ryood/FV01/PXL_20220813_064847675.jpg

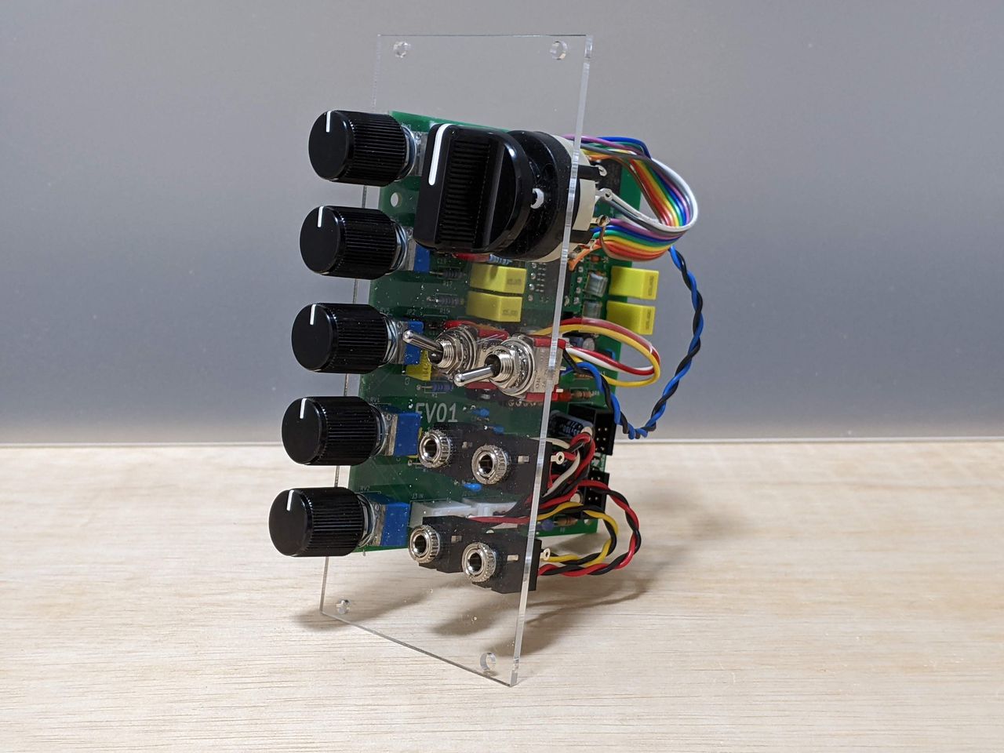
PXL_20220813_064847675.jpg
