ryood/FV01/PXL_20220806_094359794.jpg

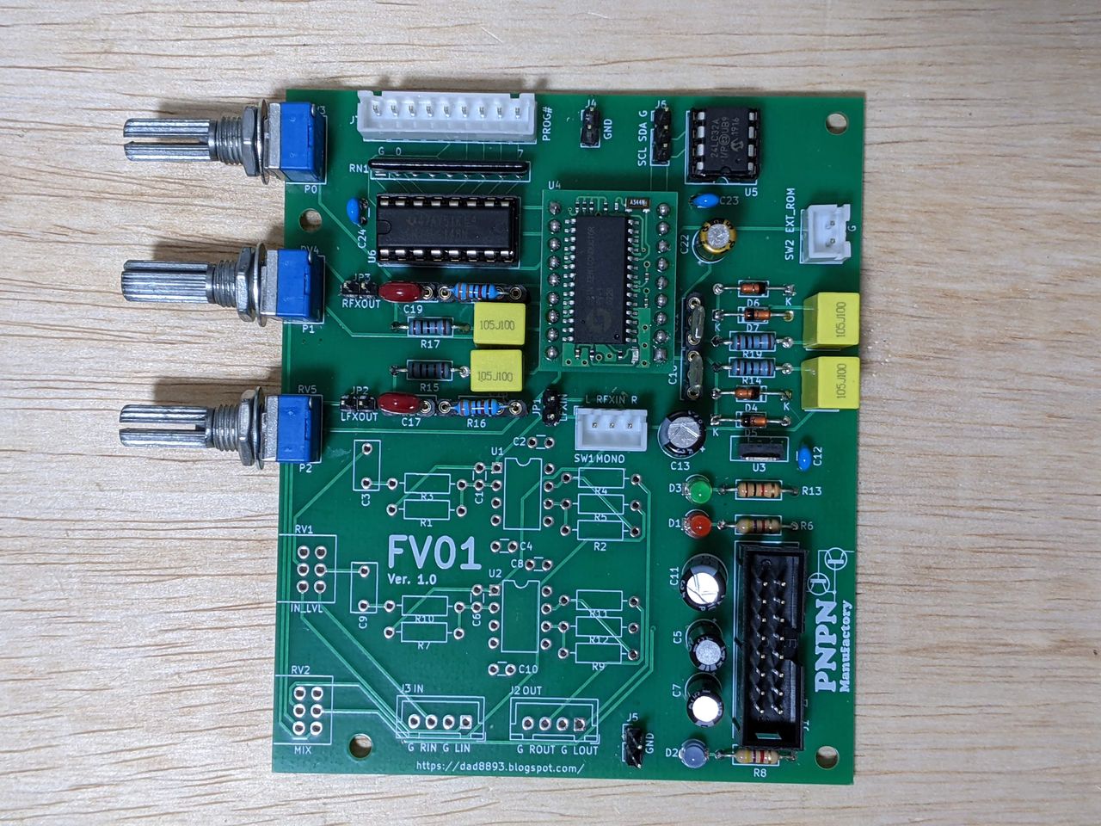
PXL_20220806_094359794.jpg
