ryood/FV01/FV01_Interface測定/FxOut-Out-INOUT_Lch.png

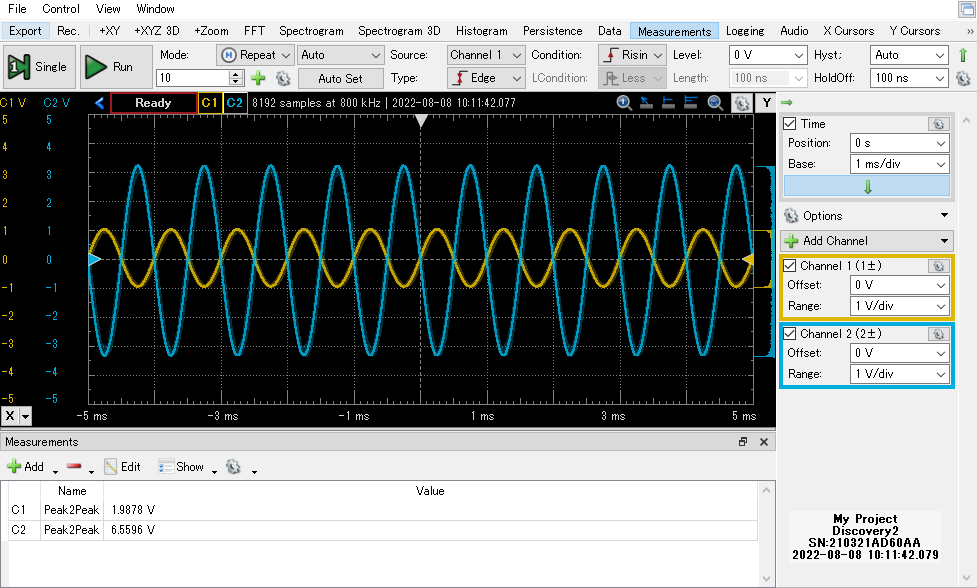
FV01_Interface測定/FxOut-Out-INOUT_Lch.png
