ryood/FV01/FV01_Interface測定/FxOut-Out-Network_Lch.png

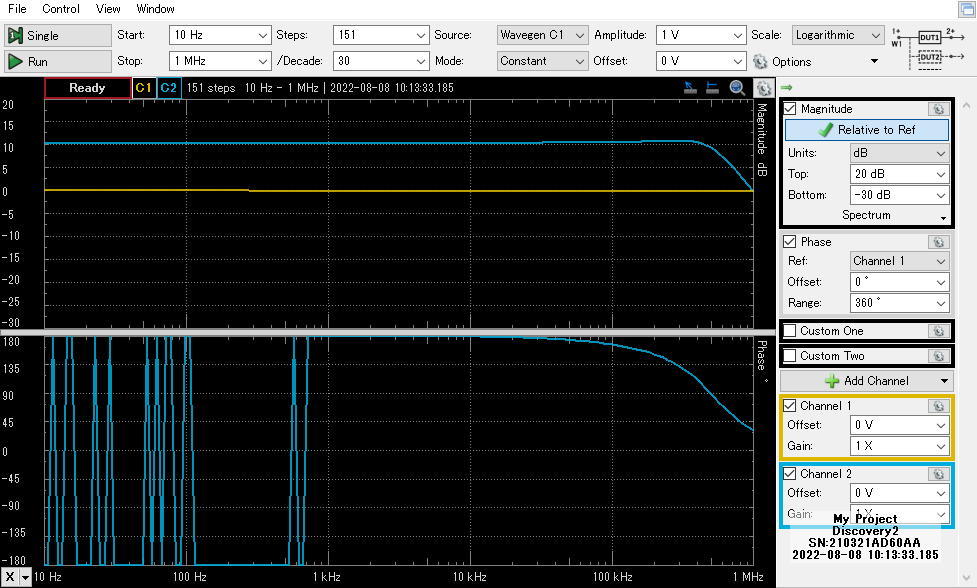
FV01_Interface測定/FxOut-Out-Network_Lch.png
