ryood/FV01/FV01_Interface測定/In-FxIn-INOUT_Lch.png

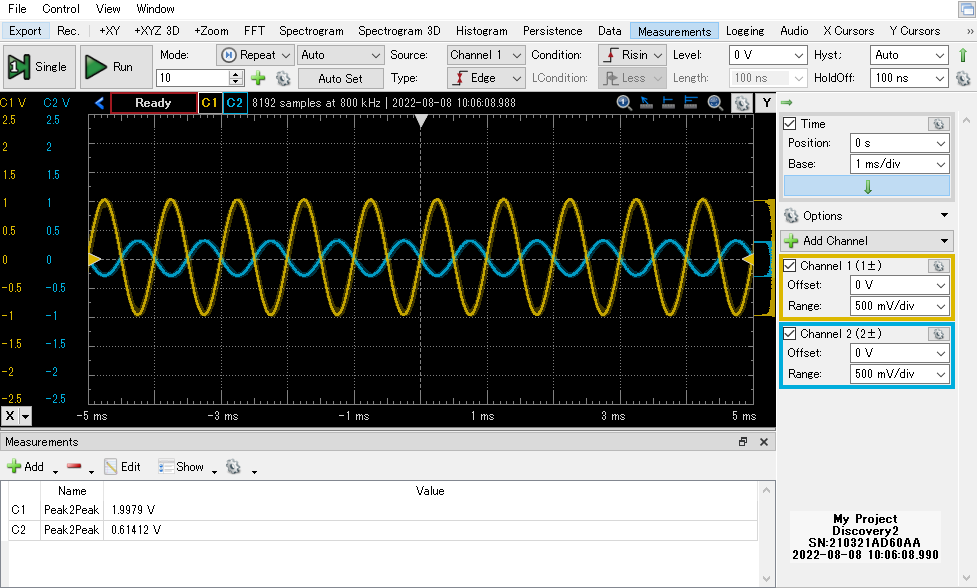
FV01_Interface測定/In-FxIn-INOUT_Lch.png
