ryood/FV01/FV01_Interface測定/IN-FxOut-Mix-Inv-LMax_Lch.PNG

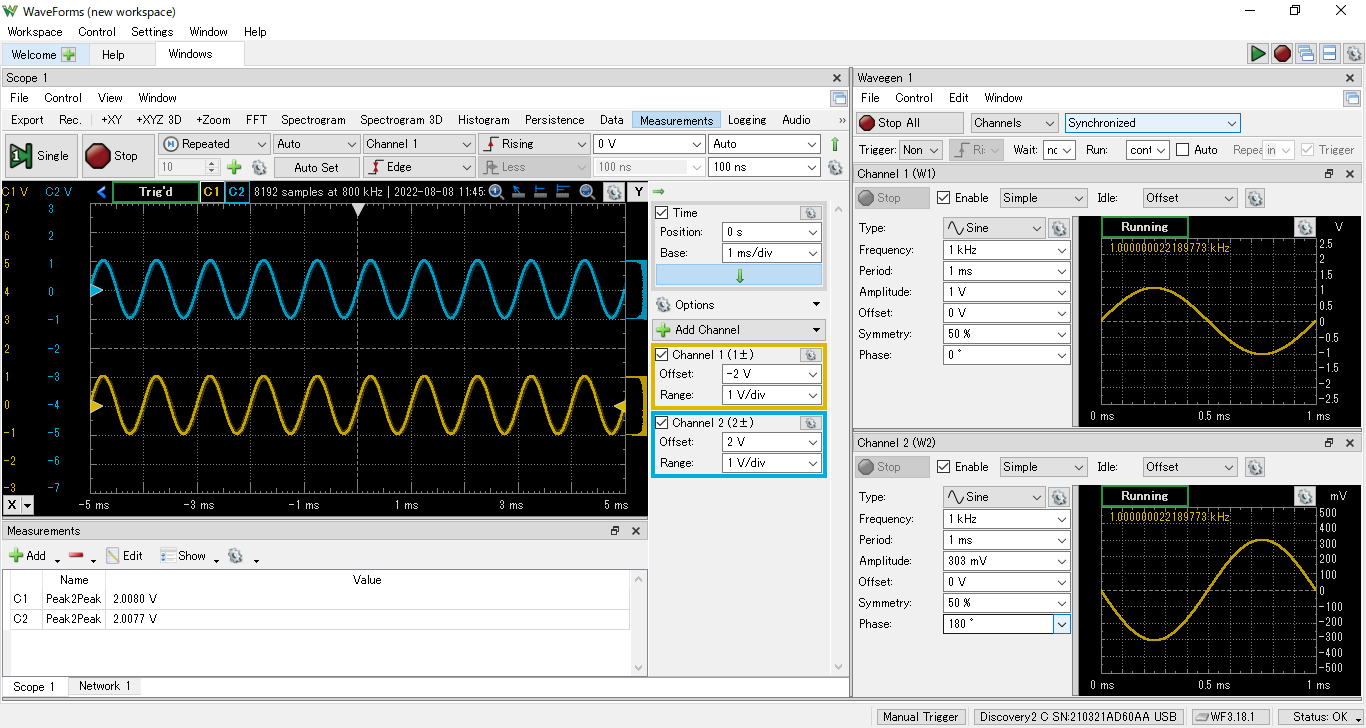
FV01_Interface測定/IN-FxOut-Mix-Inv-LMax_Lch.PNG
