ryood/FV01/FV01_Interface測定/In-Out-INOUT-LMax_Lch.png

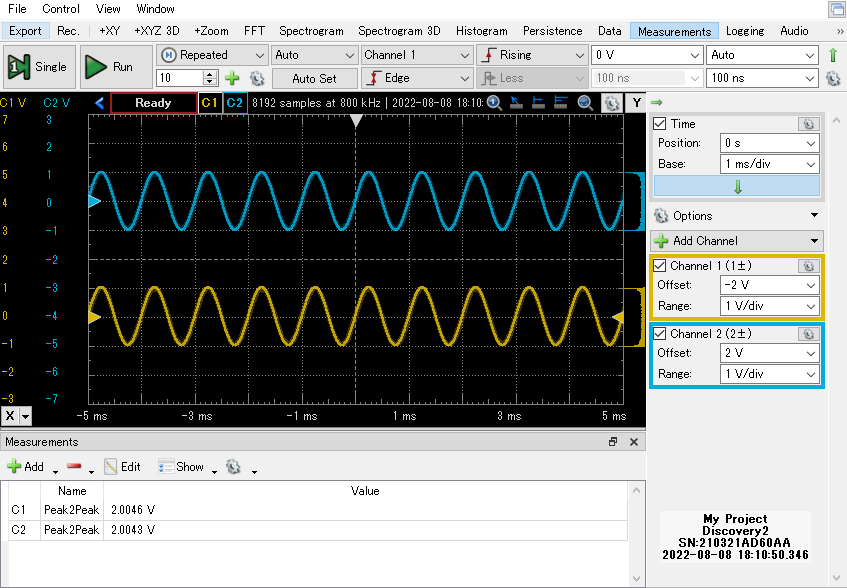
FV01_Interface測定/In-Out-INOUT-LMax_Lch.png
