ryood/FV01/FV01_Interface測定/In-Out-INOUT-RMax_Lch.png

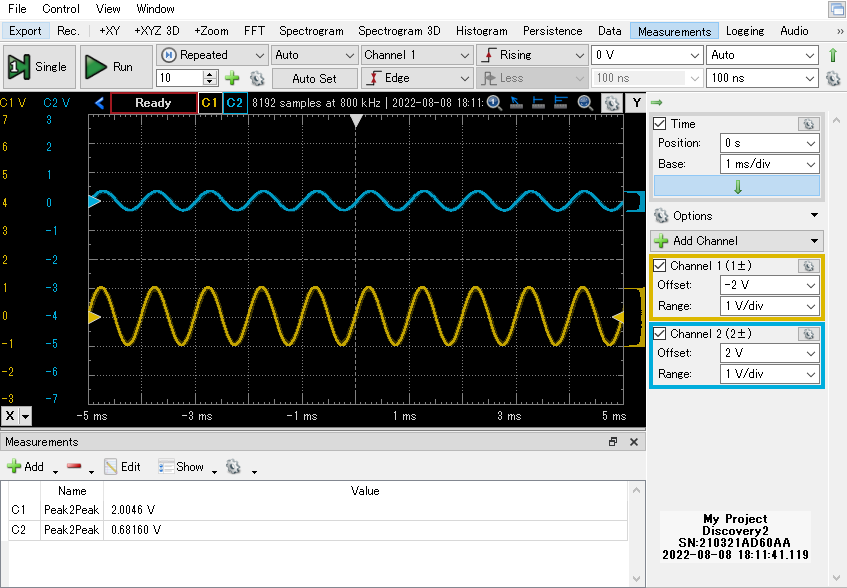
FV01_Interface測定/In-Out-INOUT-RMax_Lch.png
