ryood/FV01/FV01_Interface測定/In-Out-Network-LMax_Lch.png

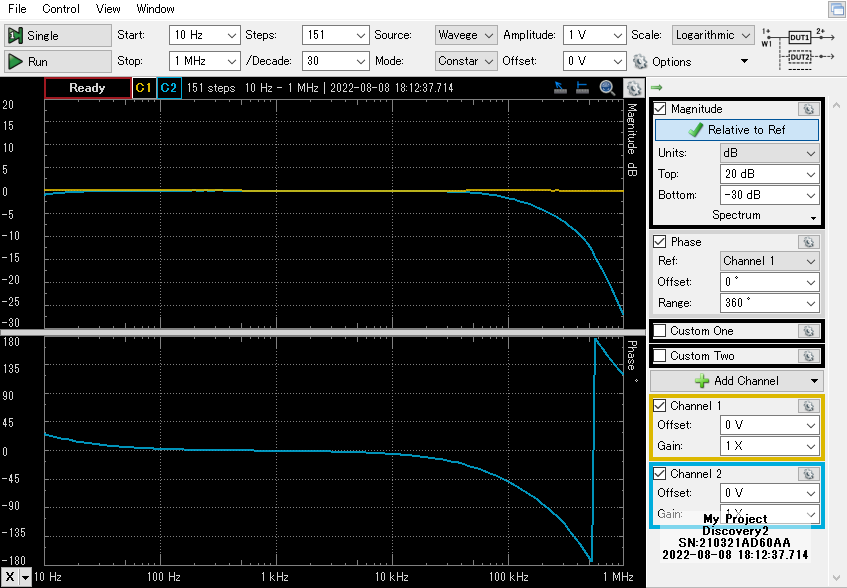
FV01_Interface測定/In-Out-Network-LMax_Lch.png
