ryood/FV01/KiCAD5/FV01.png

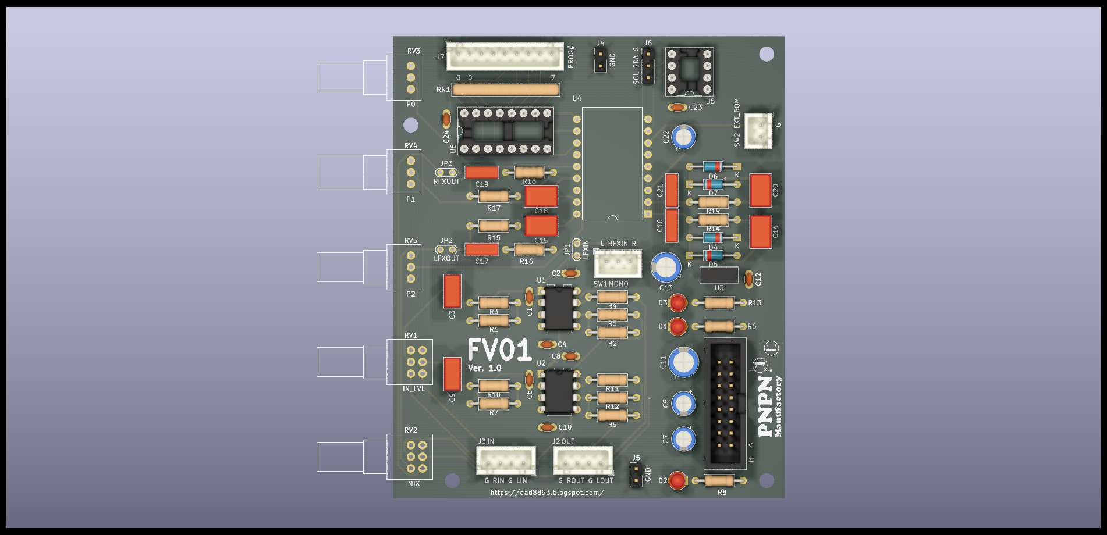
KiCAD5/FV01.png
