ryood/FV01/KiCAD5/FV01_Core_sch.png

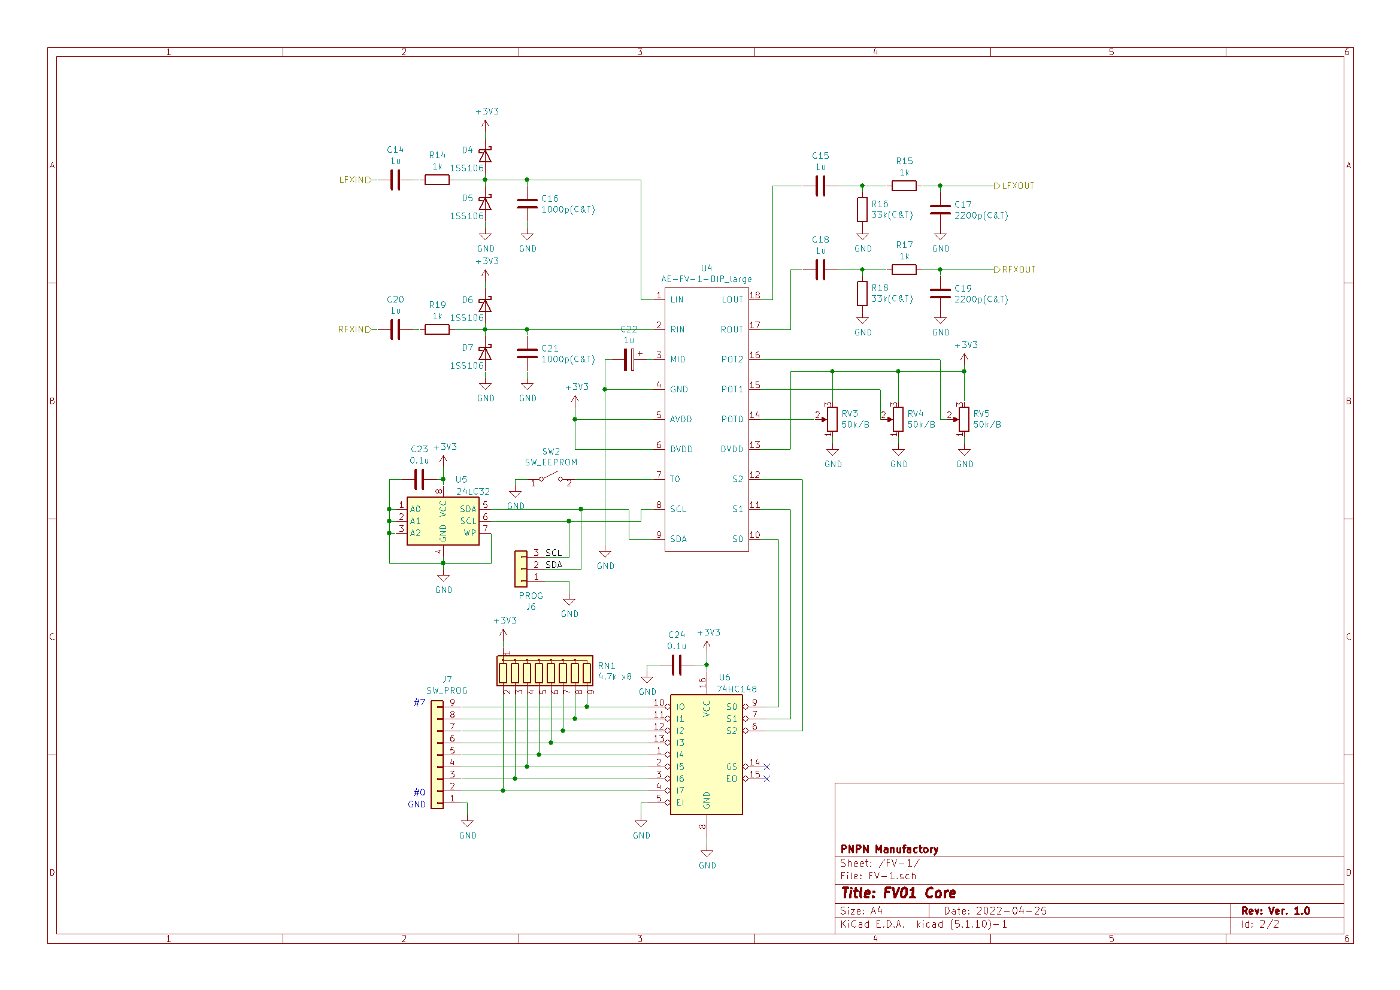
KiCAD5/FV01_Core_sch.png
