ryood/FV01/KiCAD5/FV01_sch.png

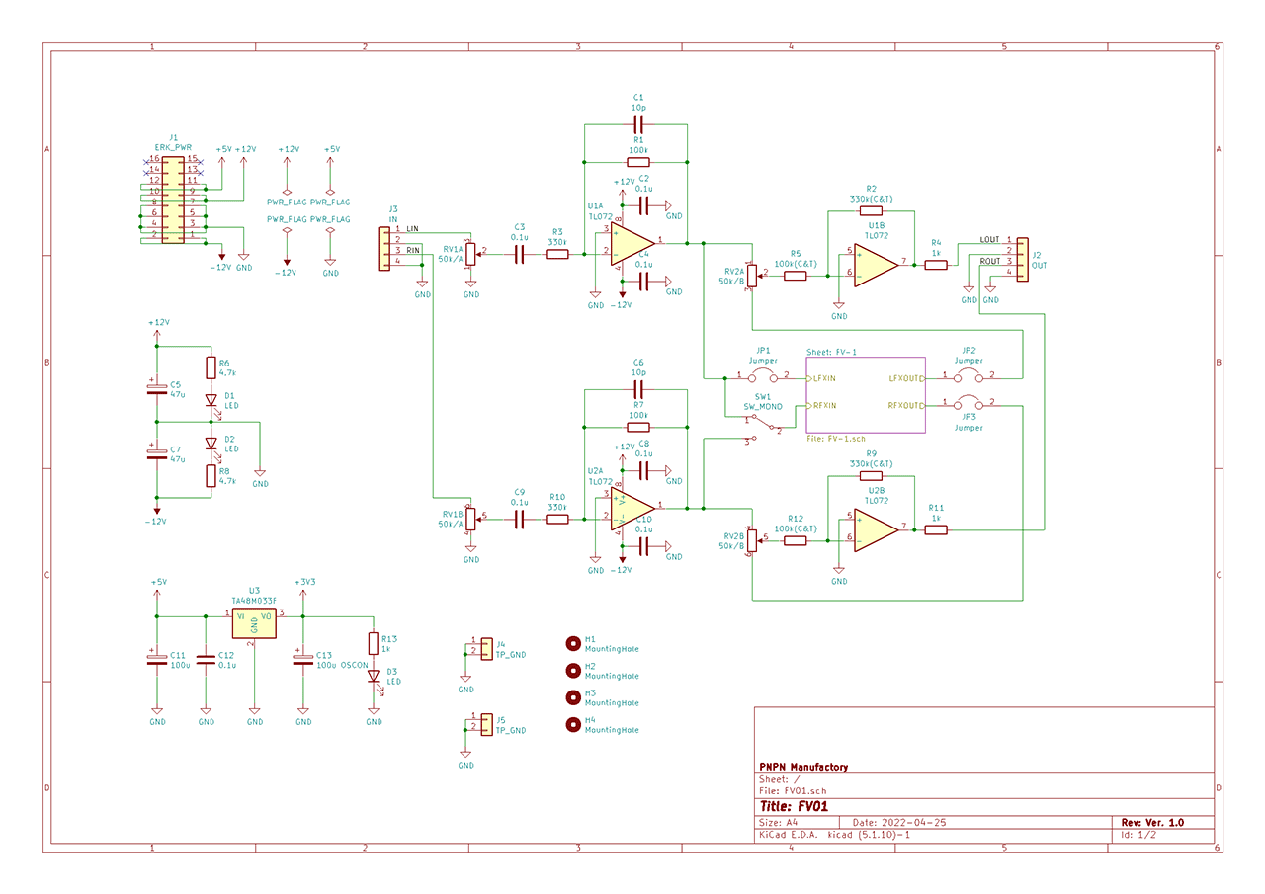
KiCAD5/FV01_sch.png
