ryood/FV01/spice/DRY_WET_1_Buffered_tran.png

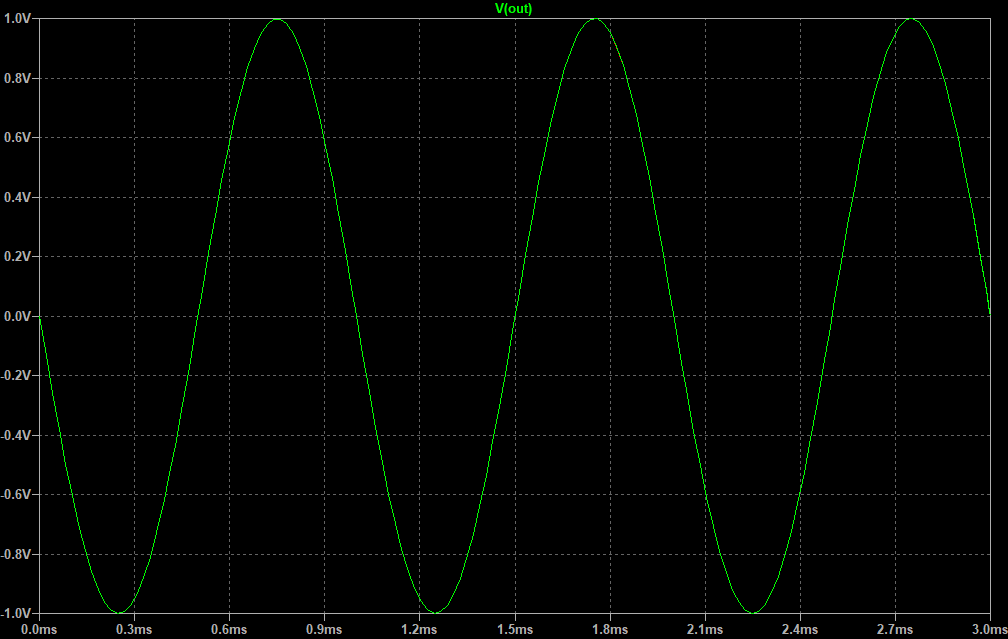
spice/DRY_WET_1_Buffered_tran.png
