ryood/FV01/spice/DRY_WET_1_NonInv_sch.png

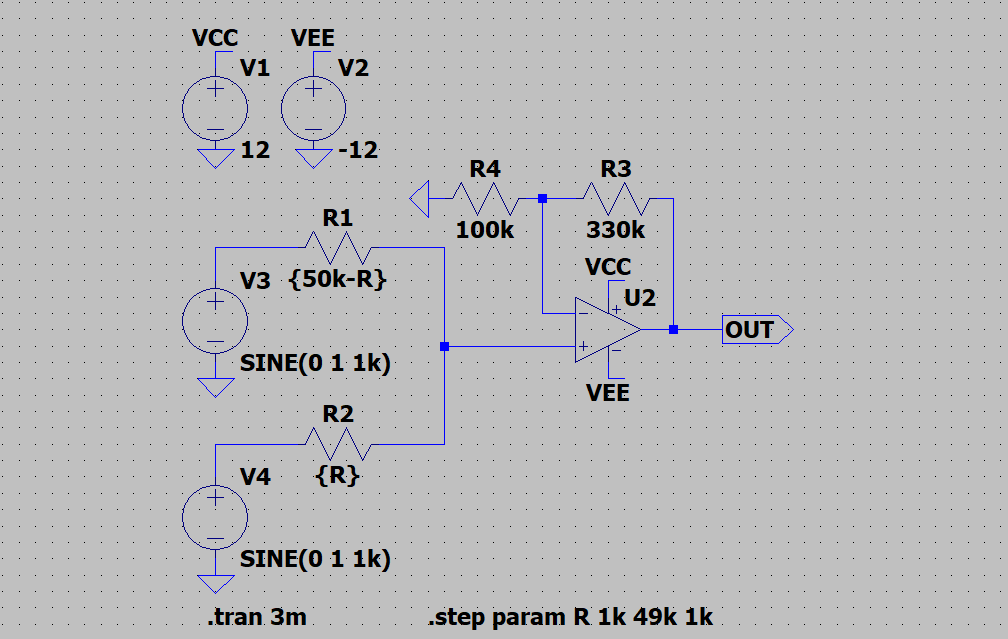
spice/DRY_WET_1_NonInv_sch.png
