ryood/FV01/spice/DRY_WET_1_NonInv_tran.png

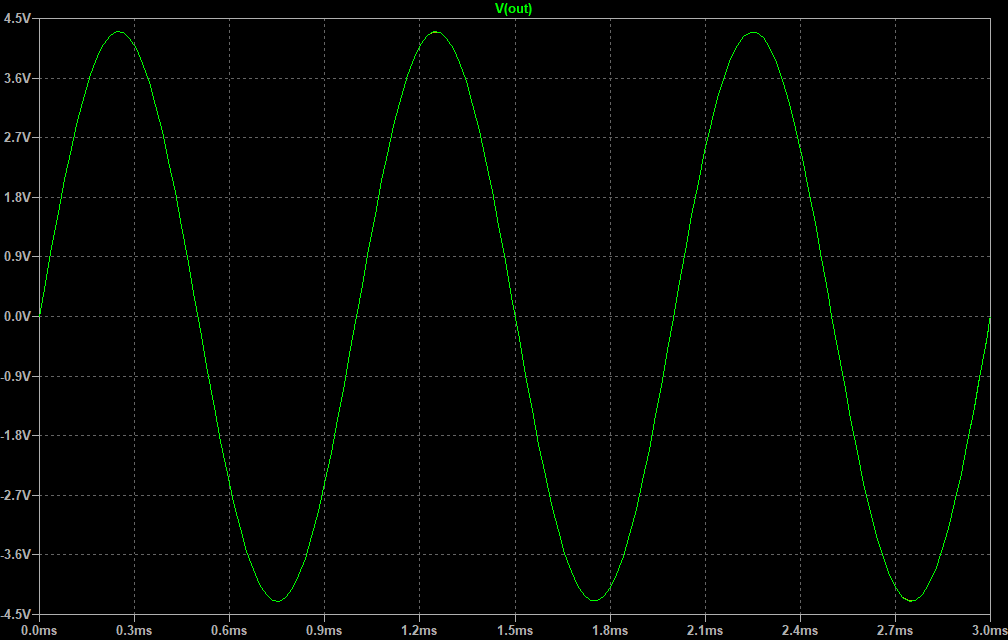
spice/DRY_WET_1_NonInv_tran.png
