ryood/FV01/spice/DRY_WET_1_sch.png

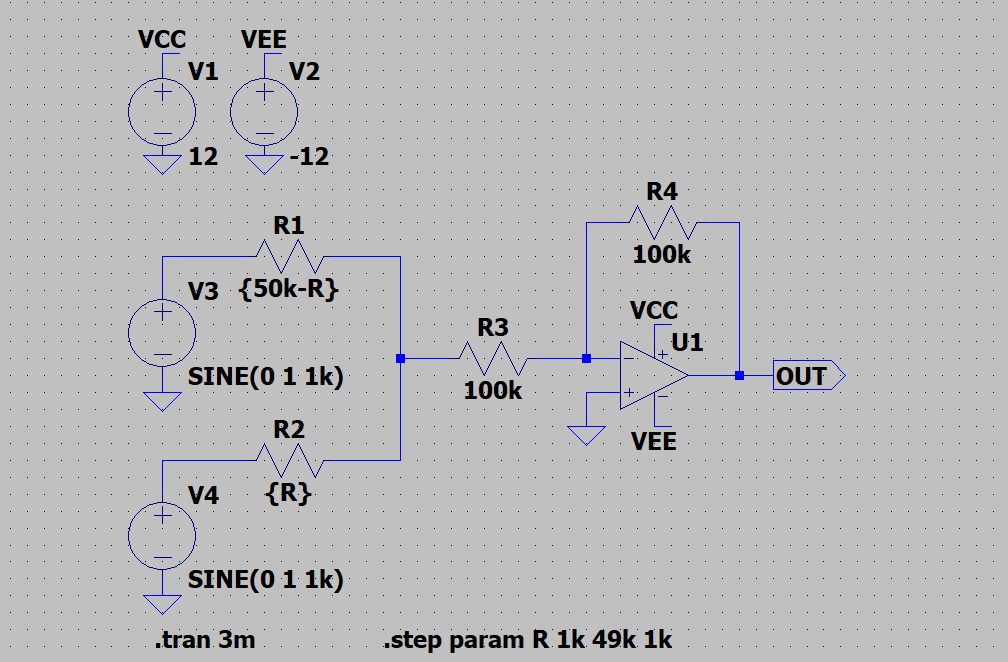
spice/DRY_WET_1_sch.png
