ryood/FV01/spice/DRY_WET_2_sch.png

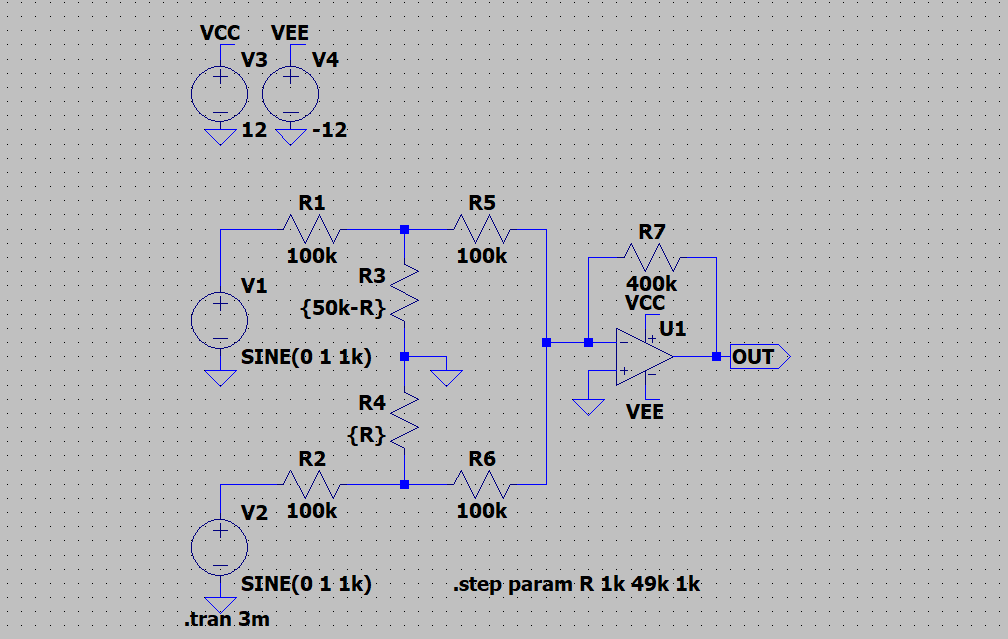
spice/DRY_WET_2_sch.png
