ryood/FV01/spice/DRY_WET_2_tran.png

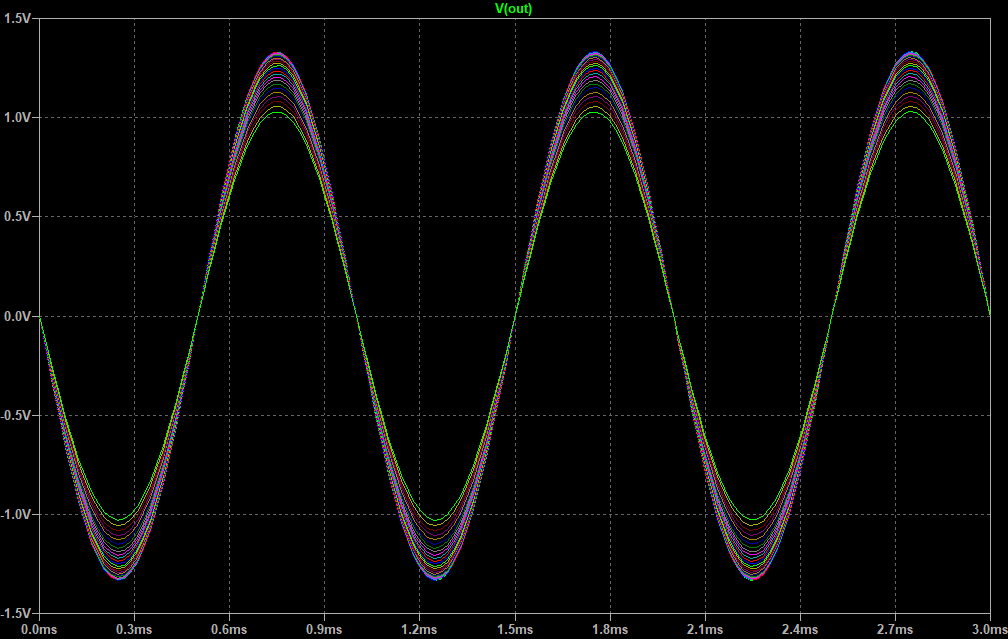
spice/DRY_WET_2_tran.png
