ryood/FV01/spice/DRY_WET_FV-1_Buffered_tran_zoom.png

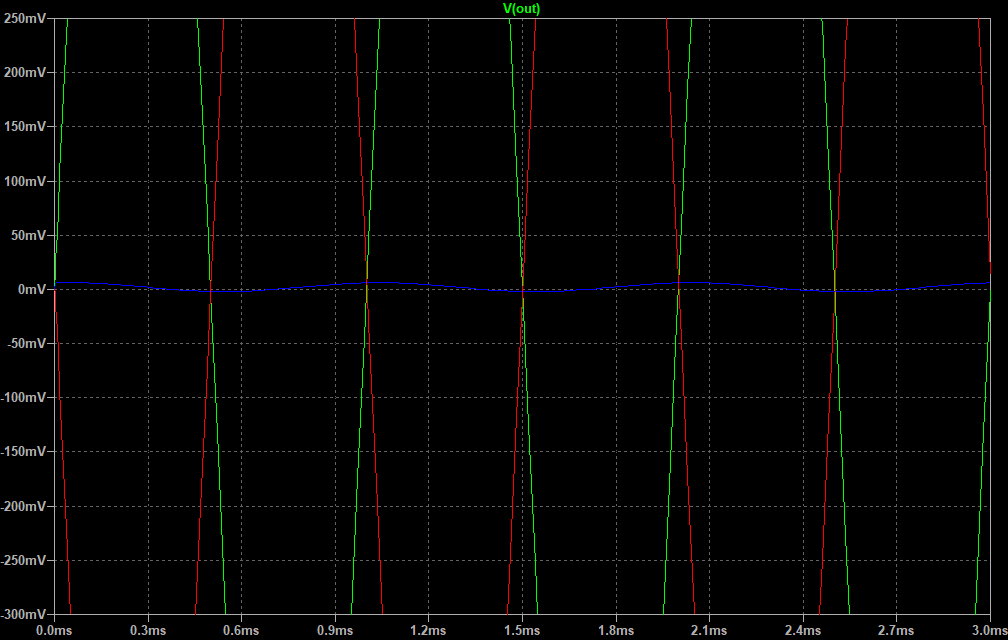
spice/DRY_WET_FV-1_Buffered_tran_zoom.png
