ryood/FV01/spice/DRY_WET_FV-1_sch.png

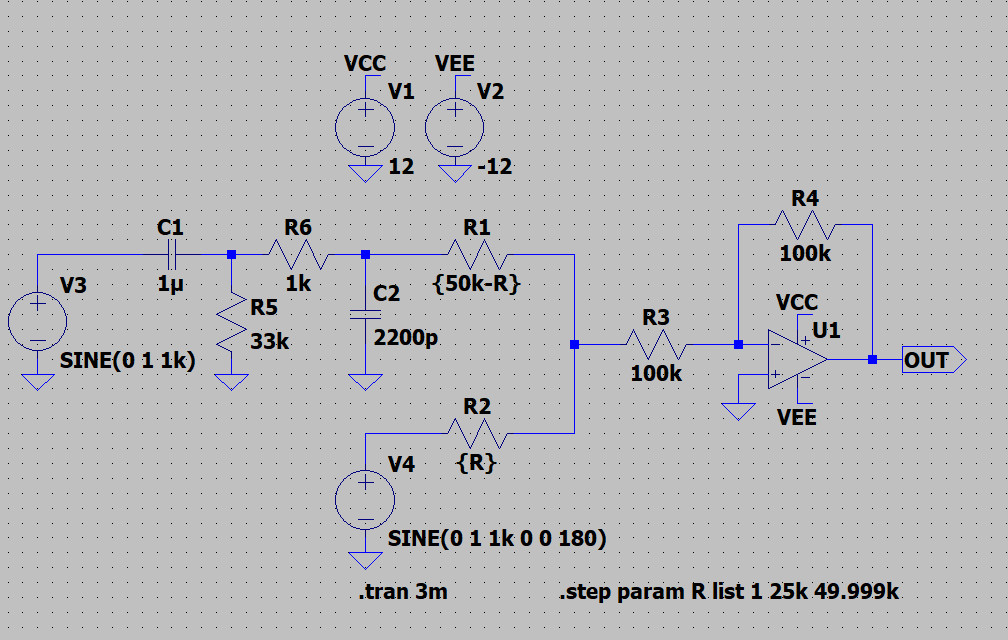
spice/DRY_WET_FV-1_sch.png
