ryood/FV01/spice/DRY_WET_FV-1_tran.png

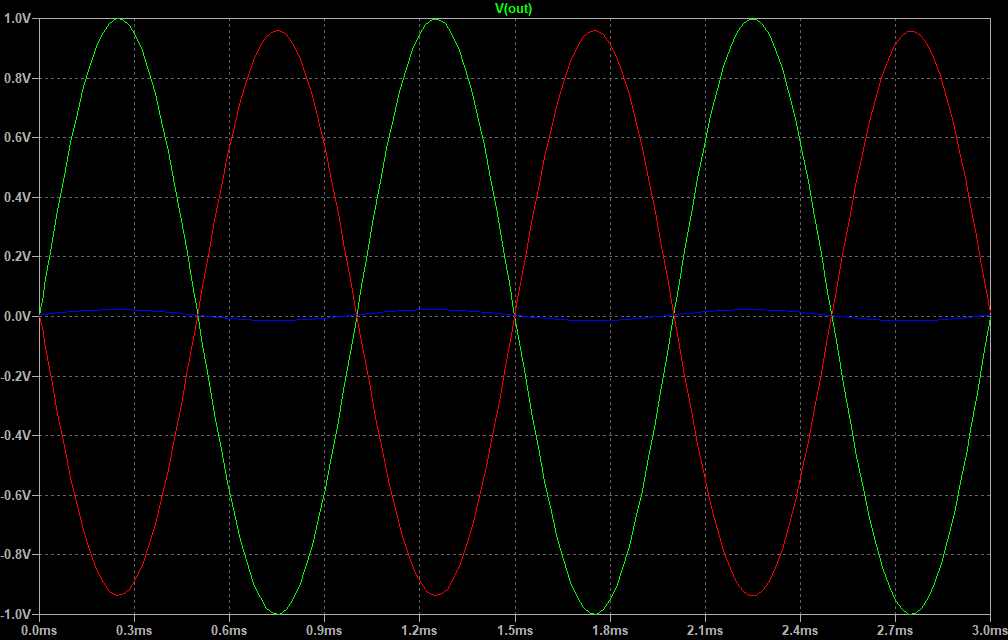
spice/DRY_WET_FV-1_tran.png
