ryood/FV01/spice/Nofilter_sch.png

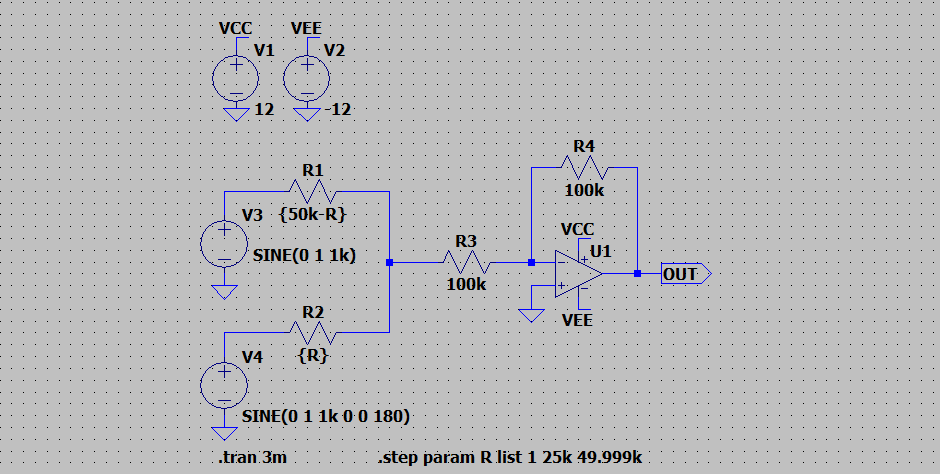
spice/Nofilter_sch.png
