ryood/FV01/spice/Nofilter_tran.png

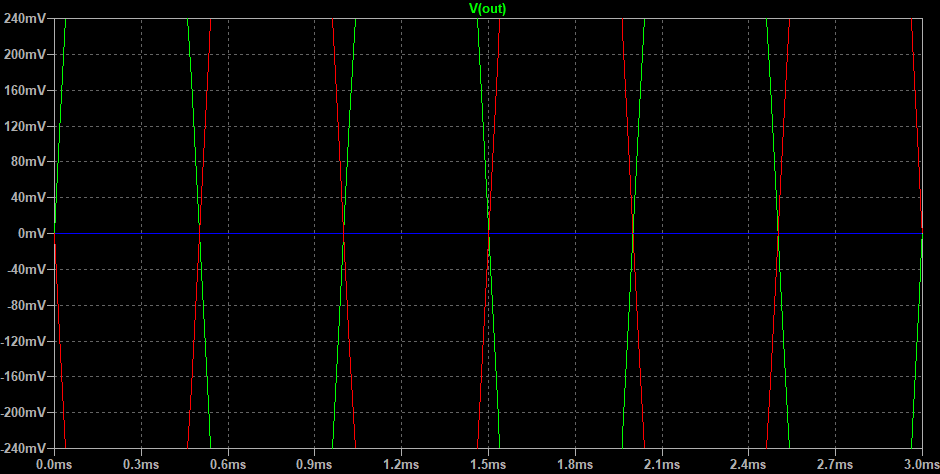
spice/Nofilter_tran.png
