ryood/FV01/SpnRomWriter/KiCAD6/PicoRomWriter_sch.png

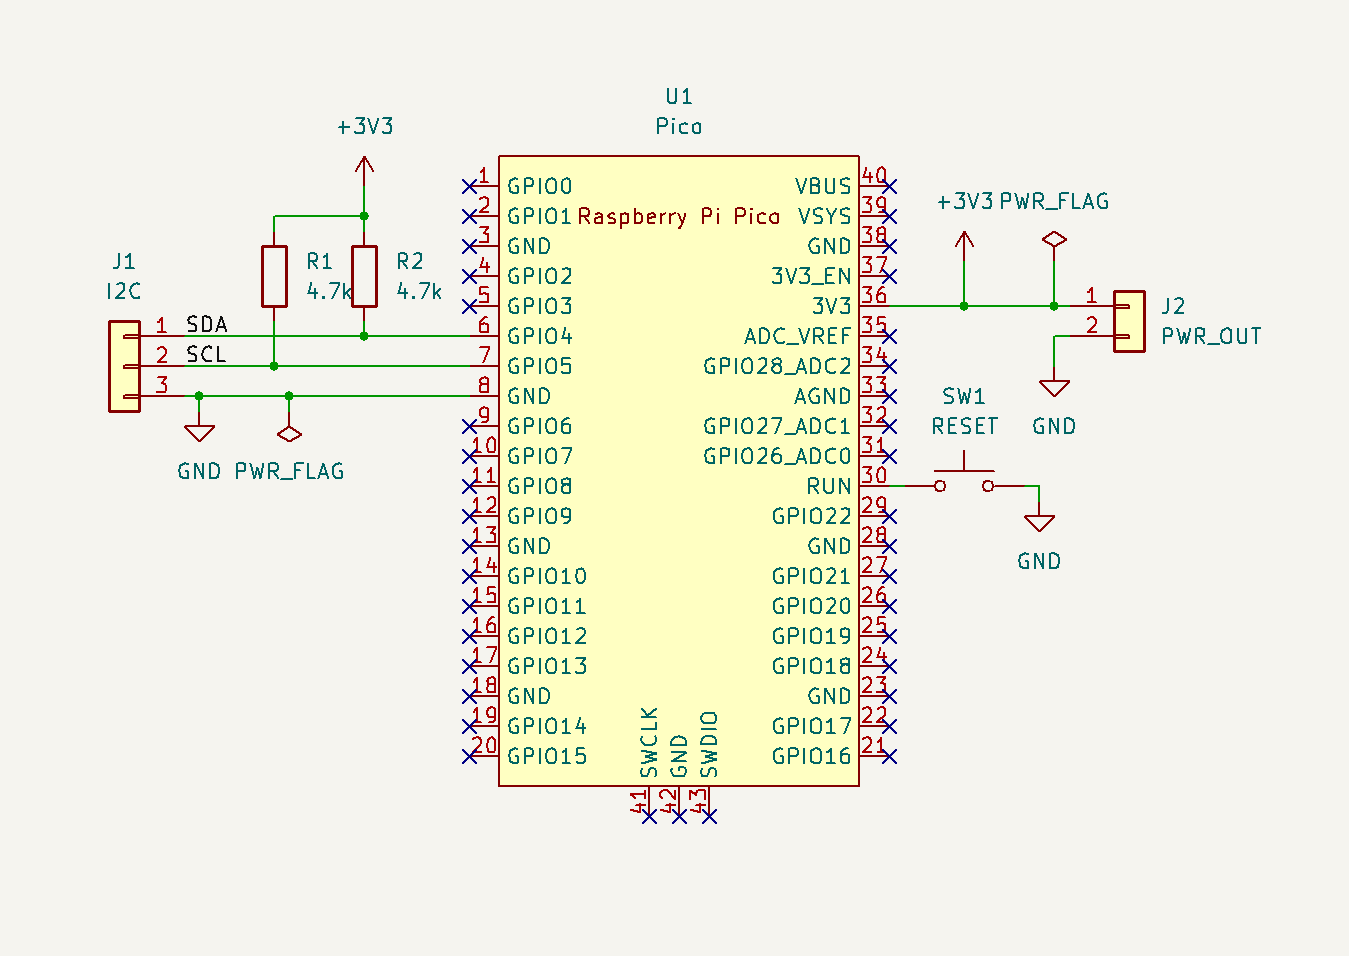
SpnRomWriter/KiCAD6/PicoRomWriter_sch.png
