ryood/FV01/(list of files, cad)

Other CAD files:
CAD/FV01_Panel.dwg
