ryood/FV01/spice/Dry_Wet_Buffered_Test_01.asc

R1: res; {50k-R}
R2: res; {R}
R3: res; 100k
R4: res; 100k
U1: UniversalOpamp2
U2: UniversalOpamp2
V1: voltage; 12
V2: voltage; -12
V3: voltage; SINE(0 1 1k)
V4: voltage; SINE(0 1 1k)
Named nets: VCC, VEE, 0, OUT
.tran 3m
.step param R 1k 49k 1k
