ryood/FV01/spice/Dry_Wet_FV-1_Buffered_Test_01.asc

C1: cap; 1µ
C2: cap; 2200p
R1: res; {50k-R}
R2: res; {R}
R3: res; 100k
R4: res; 100k
R5: res; 33k
R6: res; 1k
U1: UniversalOpamp2
U2: UniversalOpamp2
V1: voltage; 12
V2: voltage; -12
V3: voltage; SINE(0 1 1k)
V4: voltage; SINE(0 1 1k 0 0 180)
Named nets: VCC, VEE, 0, OUT
.tran 3m
.step param R list 1 25k 49.999k
