ryood/FV01/spice/Dry_Wet_Pan_Test_01.asc

R1: res; 100k
R2: res; 100k
R3: res; {50k-R}
R4: res; {R}
R5: res; 100k
R6: res; 100k
R7: res; 400k
U1: UniversalOpamp2
V1: voltage; SINE(0 1 1k)
V2: voltage; SINE(0 1 1k)
V3: voltage; 12
V4: voltage; -12
Named nets: VCC, VEE, 0, OUT
.step param R 1k 49k 1k
.tran 3m
