ryood/FV01/spice/FV01_Output_Filter.asc

C1: cap; 1µ
C2: cap; 6800p
R1: res; 15k
R2: res; 1k
V1: voltage; ""; AC 1
Named nets: 0
.ac oct 20 10 100k
