ryood/FV01/KiCAD6/FV01 Ver.1.1/FV01.kicad_pcb

## KiCad design KiCAD6/FV01 Ver.1.1/FV01.kicad_pcb (2022-10-08)

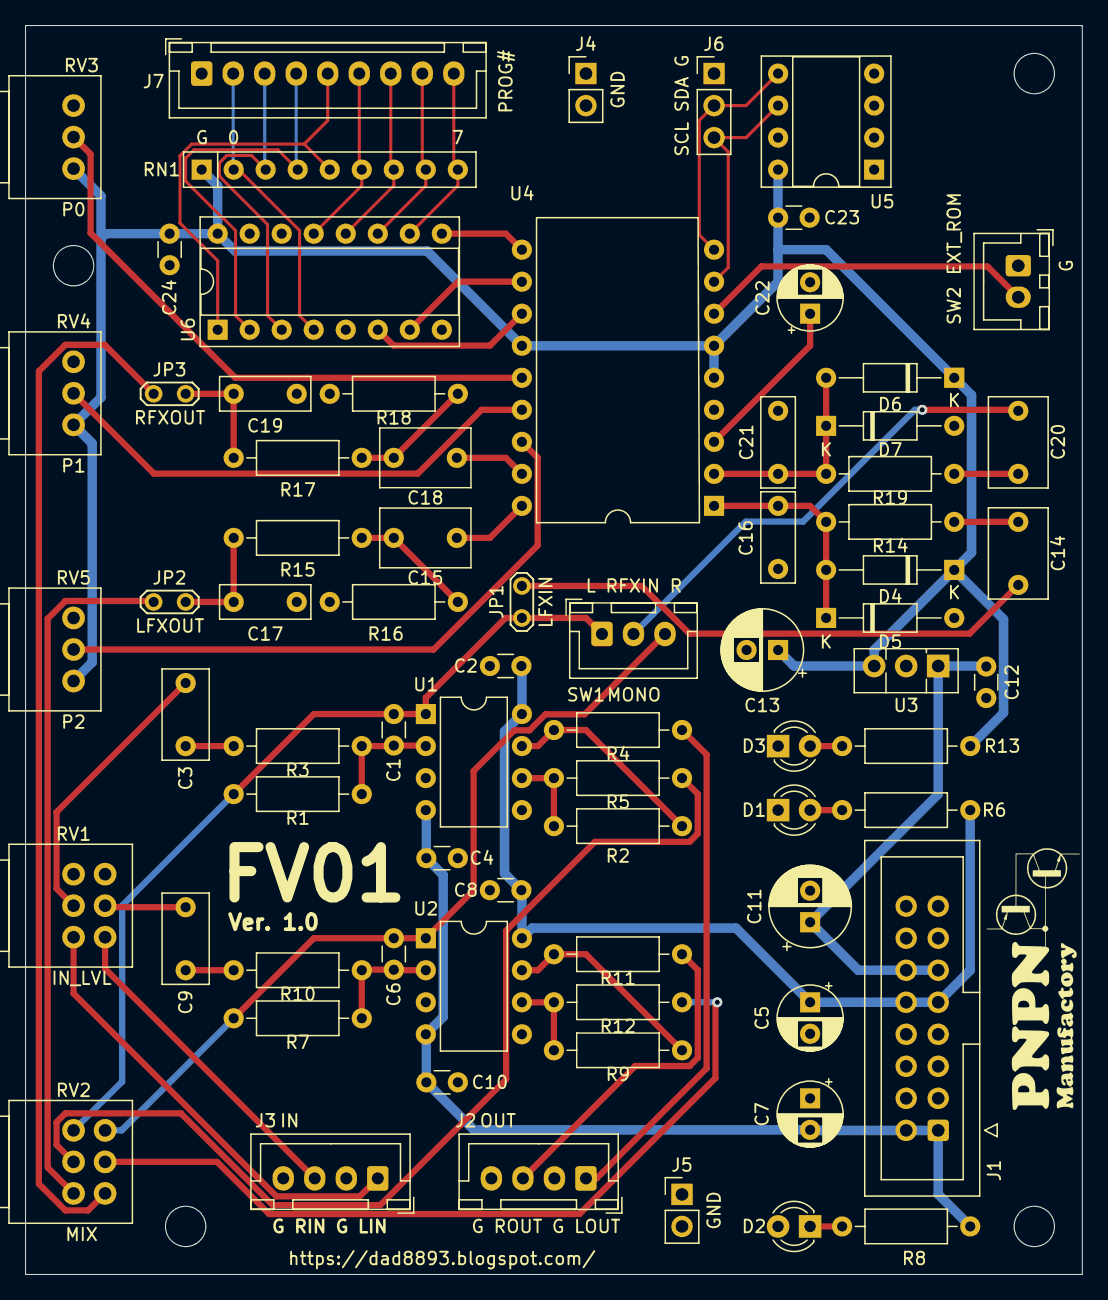
[picture p30: board FV01.kicad_pcb from above]

Board: 2 copper layers, 83.8 x 99.1 mm, 78 parts (0 on the bottom side), 58 nets.

Parts:
C1, C6: 10p; C_Disc_D3.0mm_W1.6mm_P2.50mm
C2, C4, C8, C10, C12, C23, C24: 0.1u; C_Disc_D3.0mm_W1.6mm_P2.50mm
C3, C9: 0.1u; C_Rect_L7.0mm_W3.5mm_P5.00mm
C5, C7: 47u; CP_Radial_D5.0mm_P2.50mm
C11, C13: 100u; CP_Radial_D6.3mm_P2.50mm
C14, C15, C18, C20: 1u; C_Rect_L7.0mm_W4.5mm_P5.00mm
C16, C21: 1000p(C&T); C_Rect_L7.0mm_W2.5mm_P5.00mm
C17, C19: 2200p(C&T); C_Rect_L7.0mm_W2.5mm_P5.00mm
C22: 1u; CP_Radial_D5.0mm_P2.50mm
D1, D2, D3: LED; LED_D3.0mm
D4, D5, D6, D7: 1SS106; D_DO-35_SOD27_P10.16mm_Horizontal
H1, H2, H3, H4: MountingHole; MountingHole_3.2mm_M3
J1: ERK_PWR; IDC-Header_2x08_P2.54mm_Vertical
J2: OUT; JST_XH_B4B-XH-A_1x04_P2.50mm_Vertical
J3: IN; JST_XH_B4B-XH-A_1x04_P2.50mm_Vertical
J4, J5: TP_GND; PinHeader_1x02_P2.54mm_Vertical
J6: PROG; PinHeader_1x03_P2.54mm_Vertical
J7: SW_PROG; JST_XH_B9B-XH-A_1x09_P2.50mm_Vertical
JP1, JP2, JP3: Jumper; TestPoint_2Pads_Pitch2.54mm_Drill0.8mm
R1, R7: 100k; R_Axial_DIN0207_L6.3mm_D2.5mm_P10.16mm_Horizontal
R2, R9: 330k(C&T); R_Axial_DIN0207_L6.3mm_D2.5mm_P10.16mm_Horizontal
R3, R10: 330k; R_Axial_DIN0207_L6.3mm_D2.5mm_P10.16mm_Horizontal
R4, R11, R13, R14, R15, R17, R19: 1k; R_Axial_DIN0207_L6.3mm_D2.5mm_P10.16mm_Horizontal
R5, R12: 100k(C&T); R_Axial_DIN0207_L6.3mm_D2.5mm_P10.16mm_Horizontal
R6, R8: 4.7k; R_Axial_DIN0207_L6.3mm_D2.5mm_P10.16mm_Horizontal
R16, R18: 33k(C&T); R_Axial_DIN0207_L6.3mm_D2.5mm_P10.16mm_Horizontal
RN1: 4.7k x8; R_Array_SIP9
RV1: 50k/A; Potentiometer_Alps_RK097_Dual_Horizontal
RV2: 50k/B; Potentiometer_Alps_RK097_Dual_Horizontal
RV3, RV4, RV5: 50k/B; Potentiometer_Alps_RK097_Single_Horizontal
SW1: SW_MONO; JST_XH_B3B-XH-A_1x03_P2.50mm_Vertical
SW2: SW_EEPROM; JST_XH_B2B-XH-A_1x02_P2.50mm_Vertical
U1, U2: TL072; DIP-8_W7.62mm
U3: TA48M033F; TO-126-3_Vertical
U4: AE-FV-1-DIP_large; DIP-18_W15.24mm
U5: 24LC32; DIP-8_W7.62mm_Socket
U6: 74HC148; DIP-16_W7.62mm_Socket

Connections:
+3V3: C13.1, C23.1, C24.1, D4.1, D6.1, R13.1, RN1.1, RV3.3, RV4.3, RV5.3, U3.3, U4.5, U4.6, U4.13, U5.8, U6.16
+5V: C11.1, C12.1, J1.11, J1.12, U3.1
+12V: C2.2, C5.1, C8.2, J1.9, J1.10, R6.1, U1.8, U2.8
-12V: C4.2, C7.2, C10.2, J1.1, J1.2, R8.2, U1.4, U2.4
/FV-1/LFXIN: C14.2, JP1.2
/FV-1/LFXOUT: C17.1, JP2.1, R15.1
/FV-1/RFXIN: C20.2, SW1.2
/FV-1/RFXOUT: C19.1, JP3.1, R17.1
/FV-1/SCL: J6.3, U4.8, U5.6
/FV-1/SDA: J6.2, U4.9, U5.5
/LIN: J3.1, RV1.3
/LOUT: J2.1, R4.1
/RIN: J3.3, RV1.6
/ROUT: J2.3, R11.1
GND: C2.1, C4.1, C5.2, C7.1, C8.1, C10.1, C11.2, C12.2, C13.2, C16.2, C17.2, C19.2, C21.2, C22.2, C23.2, C24.2, D1.1, D2.2, D3.1, D5.2, D7.2, J1.3, J1.4, J1.5, J1.6, J1.7, J1.8, J2.2, J2.4, J3.2, J3.4, J4.1, J4.2, J5.1, J5.2, J6.1, J7.1, R16.1, R18.1, RV1.1, RV1.4, RV3.1, RV4.1, RV5.1, SW2.1, U1.3, U1.5, U2.3, U2.5, U3.2, U4.4, U5.1, U5.2, U5.3, U5.4, U5.7, U6.5, U6.8
unnamed: C1.1, JP1.1, R1.1, RV2.1, SW1.1, U1.1
unnamed: C1.2, R1.2, R3.1, U1.2
unnamed: C3.1, R3.2
unnamed: C3.2, RV1.2
unnamed: C6.1, R7.1, RV2.4, SW1.3, U2.1
unnamed: C6.2, R7.2, R10.1, U2.2
unnamed: C9.1, R10.2
unnamed: C9.2, RV1.5
unnamed: C14.1, R14.2
unnamed: C15.1, R15.2, R16.2
unnamed: C15.2, U4.18
unnamed: C16.1, D4.2, D5.1, R14.1, U4.1
unnamed: C18.1, R17.2, R18.2
unnamed: C18.2, U4.17
unnamed: C20.1, R19.2
unnamed: C21.1, D6.2, D7.1, R19.1, U4.2
unnamed: C22.1, U4.3
unnamed: D1.2, R6.2
unnamed: D2.1, R8.1
unnamed: D3.2, R13.2
unnamed: J7.2, RN1.2, U6.4
unnamed: J7.3, RN1.3, U6.3
unnamed: J7.4, RN1.4, U6.2
unnamed: J7.5, RN1.5, U6.1
unnamed: J7.6, RN1.6, U6.13
unnamed: J7.7, RN1.7, U6.12
unnamed: J7.8, RN1.8, U6.11
unnamed: J7.9, RN1.9, U6.10
unnamed: JP2.2, RV2.3
unnamed: JP3.2, RV2.6
unnamed: R2.1, R4.2, U1.7
unnamed: R2.2, R5.1, U1.6
unnamed: R5.2, RV2.2
unnamed: R9.1, R11.2, U2.7
unnamed: R9.2, R12.1, U2.6
unnamed: R12.2, RV2.5
unnamed: RV3.2, U4.14
unnamed: RV4.2, U4.15
unnamed: RV5.2, U4.16
unnamed: SW2.2, U4.7
unnamed: U4.10, U6.9
unnamed: U4.11, U6.7
unnamed: U4.12, U6.6
