ryood/FV01/SpnRomWriter/KiCAD6/PicoRomWriter/PicoRomWriter.kicad_pcb

## KiCad design SpnRomWriter/KiCAD6/PicoRomWriter/PicoRomWriter.kicad_pcb (2022-08-20)

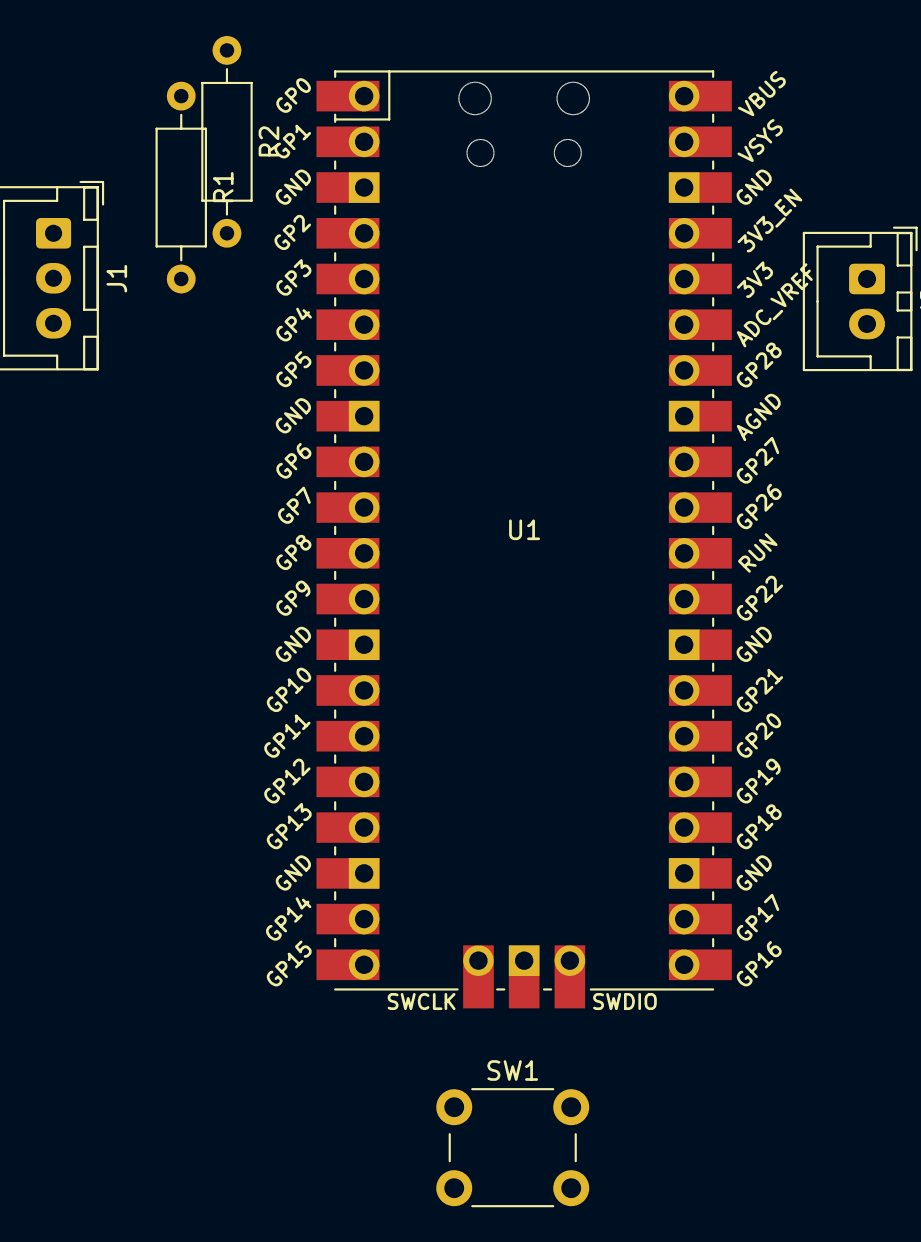
[picture p31: board PicoRomWriter.kicad_pcb from above]

Board: 2 copper layers, 6 parts (0 on the bottom side), 5 nets, no tracks yet.

Parts:
J1: I2C; JST_XH_B3B-XH-A_1x03_P2.50mm_Vertical
J2: PWR_OUT; JST_XH_B2B-XH-A_1x02_P2.50mm_Vertical
R1, R2: 4.7k; R_Axial_DIN0207_L6.3mm_D2.5mm_P10.16mm_Horizontal
SW1: RESET; SW_PUSH_6mm_H8.5mm
U1: Pico; RPi_Pico_SMD_TH

Connections:
+3V3: J2.1, R1.1, R2.1, U1.36 (3V3)
/SCL: J1.2, R1.2, U1.5 (GPIO3)
/SDA: J1.1, R2.2, U1.4 (GPIO2)
GND: J1.3, J2.2, SW1.2, U1.8 (GND)
unnamed: SW1.1, U1.30 (RUN)
