ryood/FV01/(commit log)

2022-08-11 Panel design
    [FV-1.sch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]
2022-08-20 Blog update
    [PicoRomWriter.csv, PicoRomWriter.kicad_pcb, PicoRomWriter.kicad_sch]
2022-08-25 Blog update No.3 SpinRomWriter
    [SpinRomWriter Block Diagram.xlsx]
2022-08-28 Blog update No.4 改善策
2022-10-08 Ver.1.1 begin
    [FV-1.kicad_sch, FV-1.sch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]
